NovoselovMilk/Arduino-ELRS-Controller/README.md

# Arduino-ELRS-Controller

* [Описание проекта](#описание)  
* [Схемы](#схемы)  
  * [Схема аппаратуры управления](#схема-аппаратуры-управления-без-передающего-модуля-elrs)
  * [Схема передатчика ELRS](#схема-передатчика-elrs-tx-900mhz)
  * [Схема приемника ELRS](#схема-приемника-elrs-rx-pwm4-900mhz)
* [Антенны](#антенны)
* [Калибровка стиков](#калибровка-стиков)
* [Управление мощностью и скоростью передачи пакетов](#управление-мощностью-и-скоростью-передачи-пакетов)
* [Ссылки на комплектующие](#ссылки-на-комплектующие)

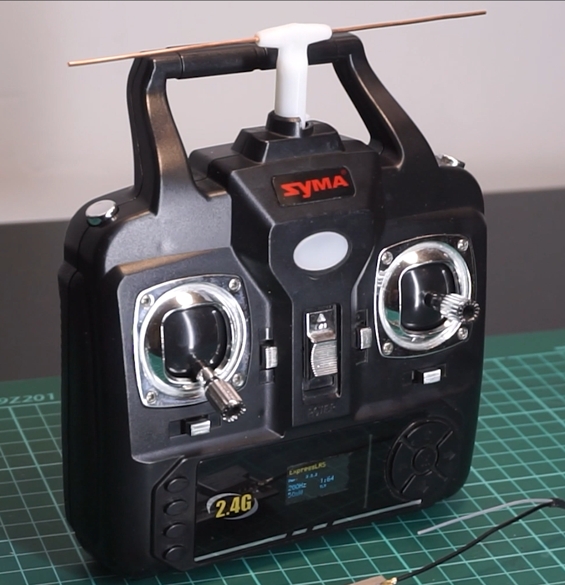
[picture p1: doc/1.png]

</p>

## Описание

Проект "Arduino ELRS controller" предназначен для создания аппаратуры управления на базе Arduino в связке с модулями ExpressLRS как самодельными, так и с заводскими. Реализовать этот проект можно на любой компонентной базе. Видео по сборке этого проекта можно посмотреть на YouTube "[ДАЛЬНОБОЙНАЯ ARDUINO аппаратура управления || ExpressLRS](https://youtu.be/eXaWpuBfFW8?si=YdgBgIKVBinbROiB)"

Общение с ELRS модулем построенно на базе проекта "[Simple TX](https://github.com/kkbin505/Arduino-Transmitter-for-ELRS)"

## Схемы

### Схема аппаратуры управления (без передающего модуля ELRS)

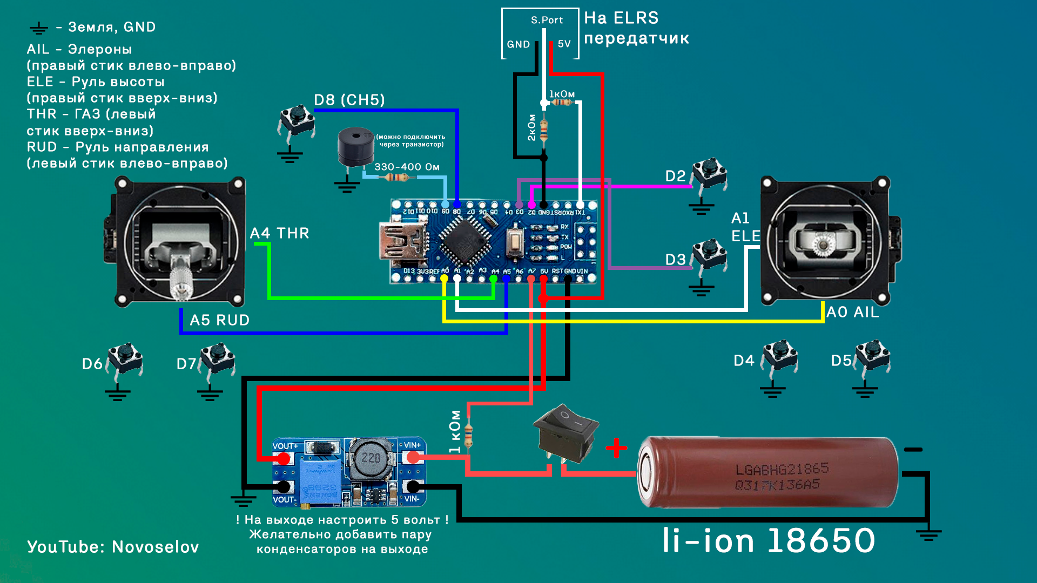
[picture p2: doc/arduino_controller.png]
Schematic_arduino

___

### Схема передатчика ELRS TX 900MHz

Ссылка на проект в EasyEDA - "[ELRS TX](https://oshwlab.com/redbanannas/elrs_tx)"

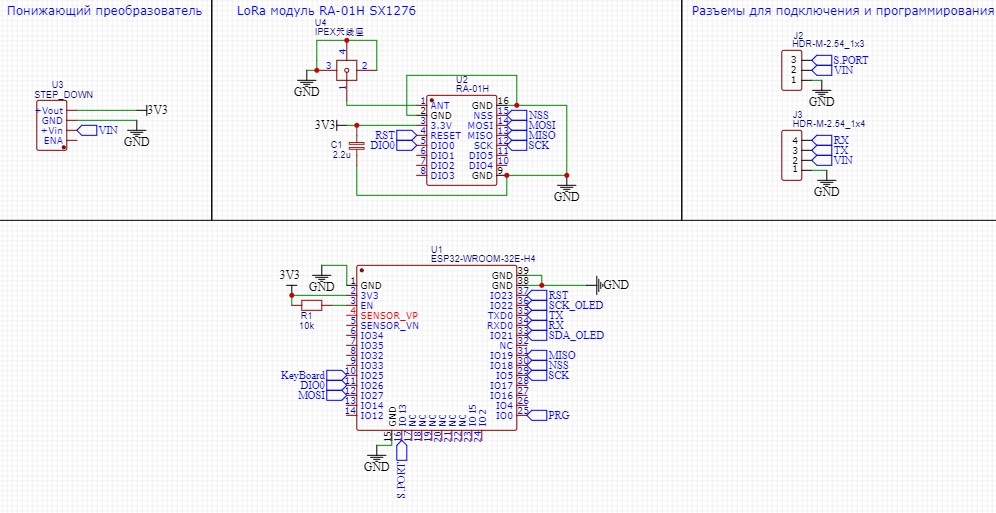
[picture p3: schematics/TX_ELRS.png]
TX

___

### Схема приемника ELRS RX PWM4 900MHz

Ссылка на проект в EasyEDA - "[ELRS RX](https://oshwlab.com/redbanannas/elrs_rx)"
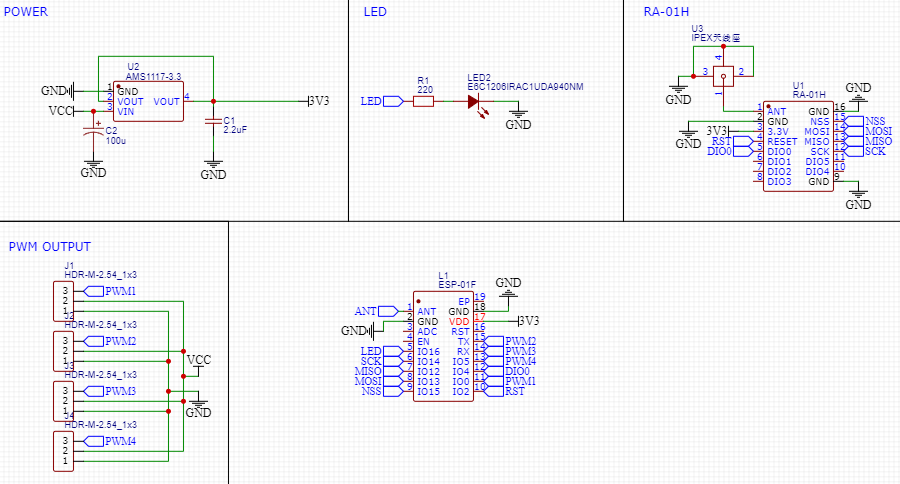
[picture p4: schematics/RX_ELRS.png]
RX


# Антенны

 Лучше купить готовые антенны, например вот [тут](https://aliexpress.ru/item/1005005524898189.html) , но можно и сделать их самостоятельно.

## Размеры антенн

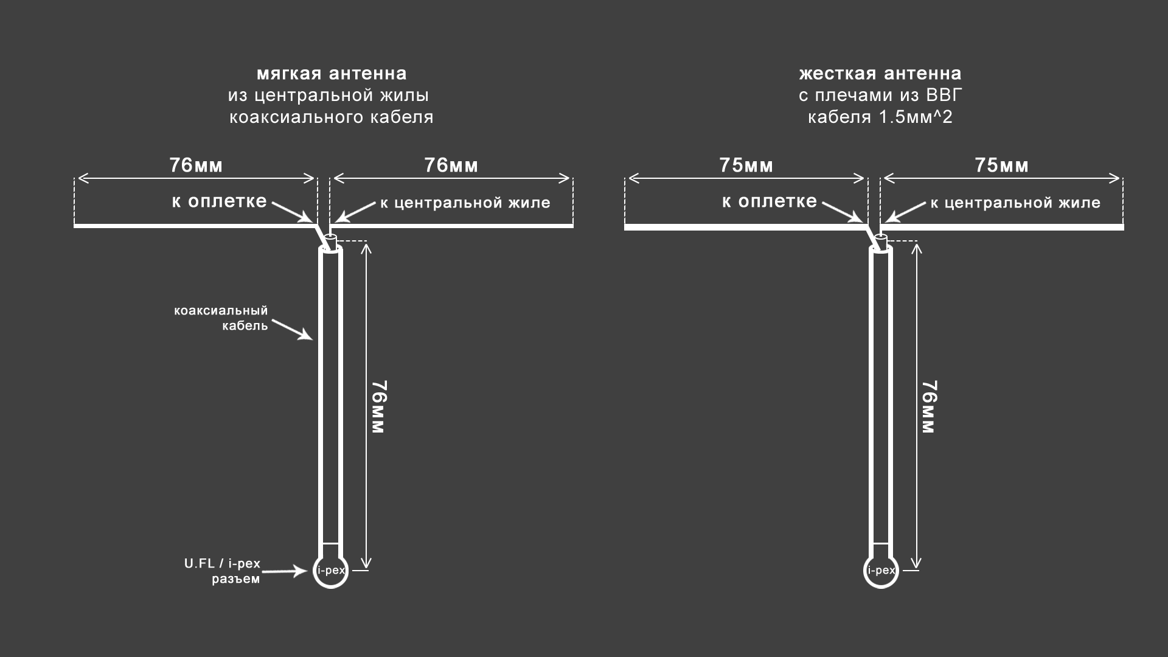
[picture p5: doc/antennas.png]
DIY_antennas


* Коаксиальный кабель 1.37mm
* i-pex(U.fl) "хвосты"
(IPEX1, 10СМ) - <https://aliexpress.ru/item/1005005110291673.html>

___

# Калибровка стиков

Для старта калибровки стиков необходимо перед включением аппаратуры зажать триммер руля высоты вниз и триммер элеронов влево, после этого включить аппаратуру.
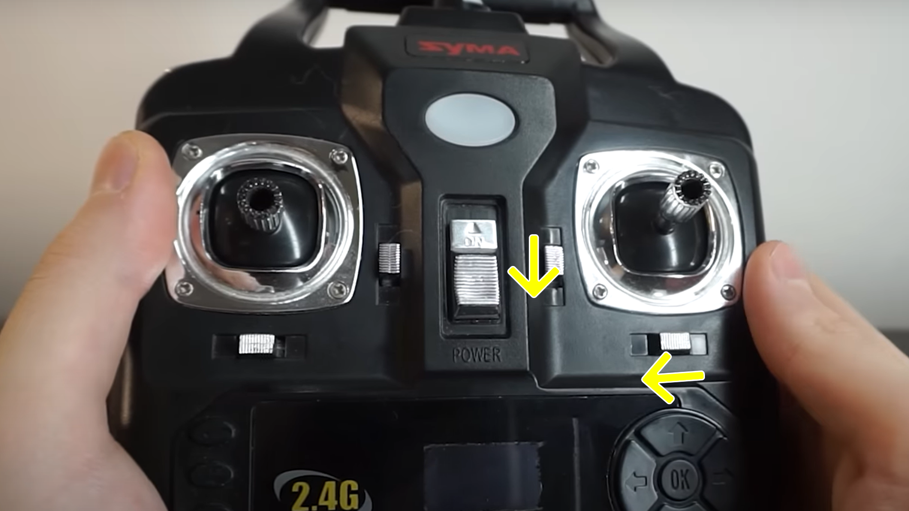
[picture p6: doc/calibrate.png]

После характерного писка аппаратуры можно начинать калибровку стиков строго по порядку:

1. Правый стик(AIL) ВПРАВО до упора, после ВЛЕВО до упора. Дожидаемся одиночного сигнала от аппаратуры
2. Правый стик(ELE) ВВЕРХ до упора, после ВНИЗ до упора. Дожидаемся одиночного сигнала от аппаратуры
3. Левый стик(THR) ВВЕРХ до упора, после ВНИЗ до упора. Дожидаемся одиночного сигнала от аппаратуры
4. Левый стик(RUD) ВПРАВО до упора, после ВЛЕВО до упора.

Дожидаемся подтверждающего радостного двойного сигнала аппаратуры. Все, калибровка завершена успешно!)

# Управление мощностью и скоростью передачи пакетов

Управлять мощностью передатчика и скоростью передачи пакетов можно с помощью стиков. Для этого необходимо при включении отклонить соответствующий стик в крайнее положение.
  
  Управление мощностью:

* Левый стик влево (RUD) - 25 mW
* Левый стик вправо (RUD) - 50 mW

Управление скоростью передачи пакетов:

* Правый стик влево (AIL) - 25 Hz
* Правый стик вправо (AIL) - 50 Hz
* Правый стик вниз (ELE) - 100 Hz
* Правый стик вверх (ELE) - 200 Hz

__С версии 3.3.0 перестал работать неинвертированный UART, поэтому настройки могут не изменяться. Необходимо прошить передатчик на версию 3.3.0 и через веб-интерфейс (Wi-Fi) убрать галочку "uart inverted".__  Приемники с версией прошивки 3.x.x будут без проблем подключаться к передатчику с версией 3.3.0

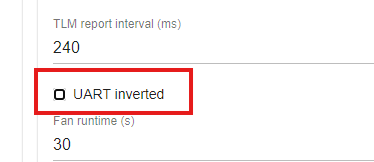
[picture p7: doc/uart.png]
uart_settings


# Прошивка ELRS

Прошиваются ESP модули с помощю USB TTL [конвертора](https://clck.ru/38auqK). Подключается TX от ESP в RX программатора, а TX в RX соответственно.

ELRS можно прошивать с помощью программы [ExpressLRS Configurator](https://github.com/ExpressLRS/ExpressLRS-Configurator/releases)

## Передатчик ELRS

* Категория устройства - __DIY devices 900 MHz__
* Устройство - __DIY TTGO V2 900MHz TX__

 В версиях выше 3.3.0 не работает неинвертированный UART, поэтому управление мощностью и скоростью передачи пакетов с помощью стиков не будет работать.
  
## Приемник ELRS

* Категория устройства - __Generic targets used as a base 900 MHz__
* Устройство - __Generic ESP8285 SX127x with PWM 900MHz RX__

В последней версии ELRS конфигуратора убрали возможность выбора Generic таргетов, поэтому можно выбрать следующий таргет:

* Категория устройства - __Happymodel 900 MHz__
* Устройство - __HappyModel EPW6 PWM RX__

# Ссылки на комплектующие

## Ардуино контроллер

* arduino nano - <https://aliexpress.ru/item/1005004904865598.html>
* Повышающий преобразователь mt3608 - <https://aliexpress.ru/item/1005005903289821.html>
* Пассивная пищалка - <https://aliexpress.ru/item/1005003490603698.html>
 Для сборки контроллера также необходимы два джойстика(гимбала) и несколько кнопок ([см. схему](#arduino-elrs-controller))

### Пищалку можно подключить через транзистор

 Будет громче работать:) Подойдет NPN транзистор 2n3904

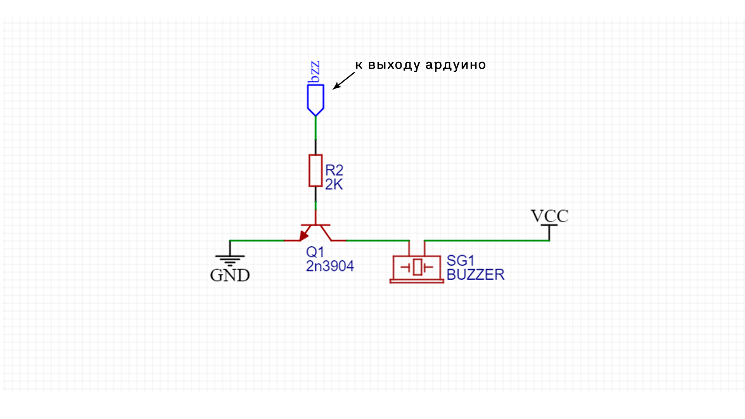
[picture p8: schematics/buzzer.png]
buzzer_schem
 
____

## ELRS Передатчик

* ESP32-WROOM-32D - <https://aliexpress.ru/item/1005001560958763.html>
* LoRa модуль Ra-01 - <https://clck.ru/38aqyS> (другой 2шт в комплекте - <https://clck.ru/38ar5W> __!РАЗЛИЧАЮТСЯ РАСПИНОВКОЙ!__ Подойдет только для сборки навесным монтажем или придется переделывать плату)
* Понижающий преобразователь - <https://clck.ru/38asGB>
* Резистор 10кОм 1206 - <https://clck.ru/38atJ5>
* Керамический конденсатор 2.2u 1206 - <https://clck.ru/38au4c> (поштучно на али не найти, поэтому рекомендую поискать в местных магазинах конденсатор 1206 с емкостью 1-5uF )
* Антенный разъем i-pex - <https://clck.ru/38asWF>
* Антенна на 900MHz - <https://clck.ru/38auKu> или <https://clck.ru/38auLi> или длинее <https://clck.ru/38auNj>
* Контактный разъем 2.54 - <https://clck.ru/38avgH>

___

## ELRS Приемник

* ESP-01F - <https://clck.ru/38arNG>
* LoRa модуль Ra-01(SX1276) - <https://aliexpress.ru/item/1005008637642000.html(другой> 2шт в комплекте - <https://aliexpress.ru/item/32981592148.html> __!РАЗЛИЧАЮТСЯ РАСПИНОВКОЙ!__ Подойдет только для сборки навесным монтажем или придется переделывать плату)
* Понижающий преобразователь AMS1117 3.3 - <https://aliexpress.ru/item/1005008229056966.html>
* Резистор 220Ом 1206 - <https://aliexpress.ru/item/1005001794439592.html>
* Светодиод 1206 - <https://aliexpress.ru/item/1005006515769651.html?sku_id=12000037495300765> 100шт!? Цвет любой.
* Керамический онденсатор 2.2u 1206 - <https://aliexpress.ru/item/1005008511664548.html?sku_id=12000045491251363>
* Электролитический конденсатор 100u 16v - <https://aliexpress.ru/item/1005006873618829.html>
* Антенный разъем i-pex - <https://aliexpress.ru/item/1005008407288917.html>
* Антенна на 900MHz - <https://aliexpress.ru/item/1005005524898189.html>
* Контактный разъем 2.54 - <https://aliexpress.ru/item/1005004954771161.html>
