NovoselovMilk/Arduino-ELRS-Controller/doc/oled.jpg

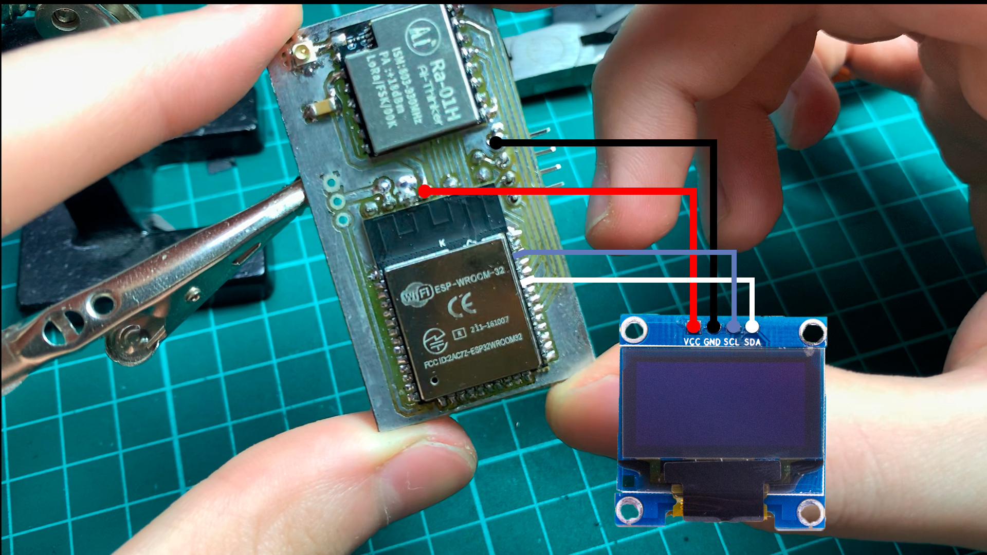
doc/oled.jpg
